ismaillgunes/IR_Programmer/hardware/IR_Programmer.kicad_pcb

## KiCad design hardware/IR_Programmer.kicad_pcb (2026-09-29)

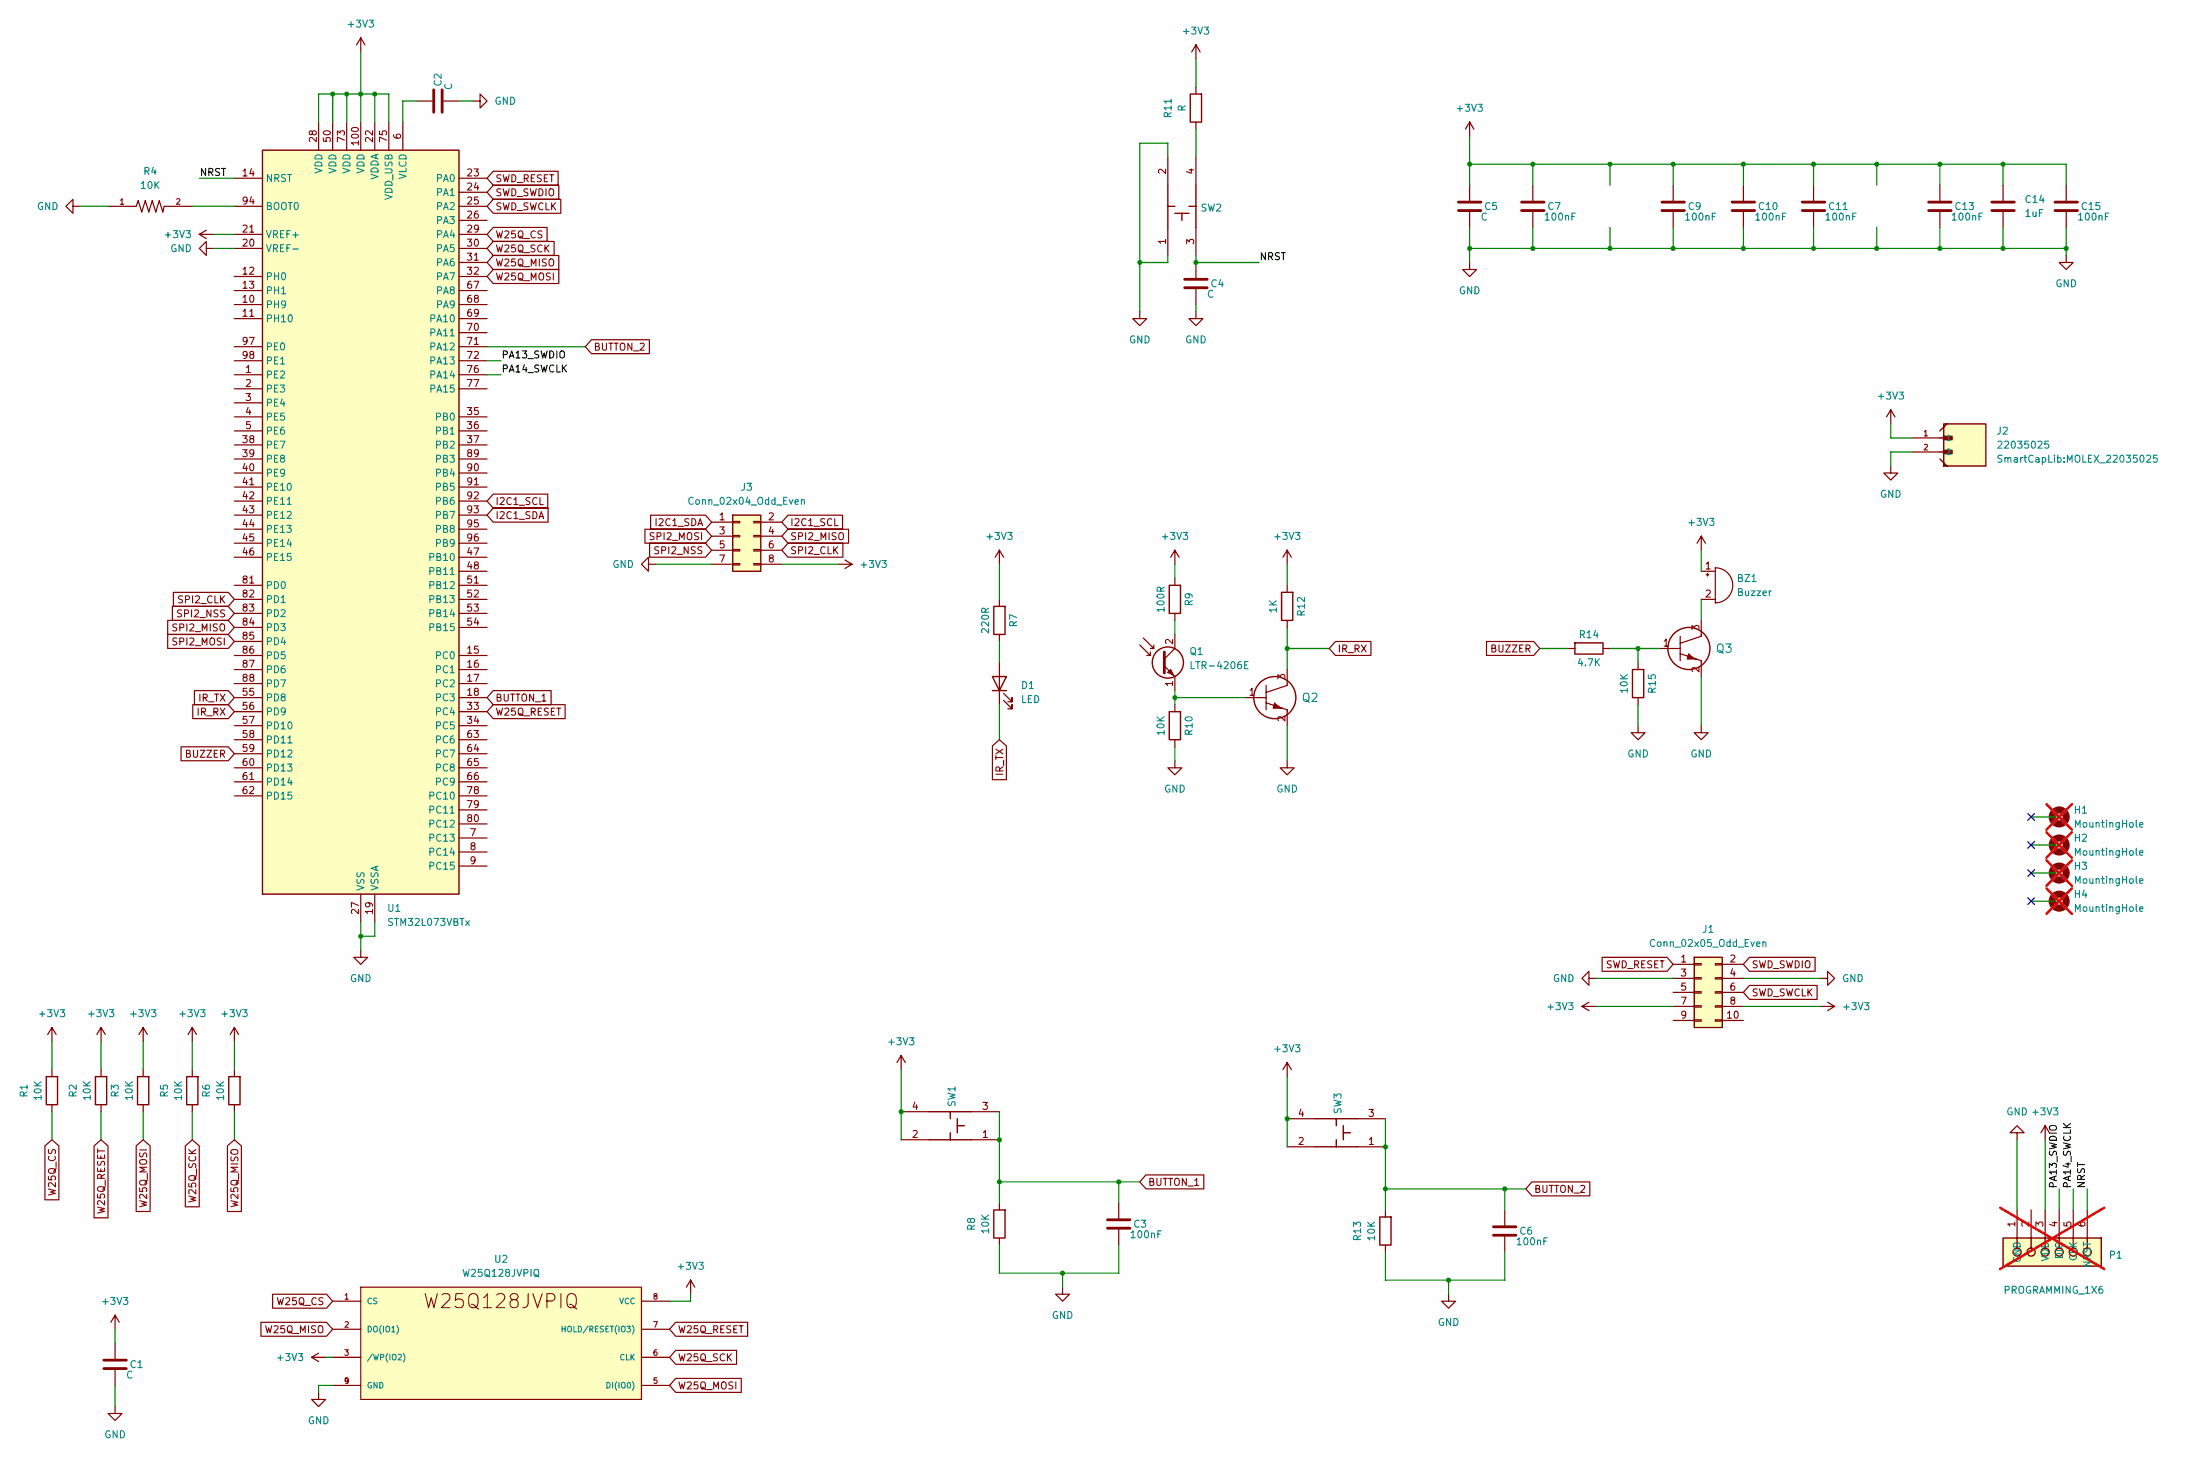
[picture p2: schematic IR_Programmer.kicad_sch]

Parts:
BZ1: Buzzer; Buzzer_12x9.5RM7.6
C1, C2, C4: C; C_0603_1608Metric; Manufacturer Part Num. CC0603KRX7R9BB104
C3, C6, C7, C9, C10, C11, C13, C15: 100nF; C_0603_1608Metric; Manufacturer Part Num. CC0603KRX7R9BB104
C5: C; C_0603_1608Metric; Manufacturer Part Num. CL10A106MQ8NNNC
C14: 1uF; C_0603_1608Metric; Manufacturer Part Number CC0603KRX7R7BB105
D1: LED; D_T-1_P2.54mm_Vertical_AnodeUp
H1, H2, H3, H4: MountingHole; MountingHole_3.5mm_Pad; not fitted
J1: Conn_02x05_Odd_Even; PinHeader_2x05_P2.54mm_Vertical
J2: 22035025; MOLEX_22035025; PARTREV A
J3: Conn_02x04_Odd_Even; PinHeader_2x04_P2.54mm_Vertical
P1: PROGRAMMING_1X6; Programming Connection; not fitted
Q1: LTR-4206E; D_T-1_P2.54mm_Vertical_AnodeUp
Q2, Q3: MMBT3904-TP; SOT-23-3
R1, R2, R3, R5, R6, R8, R10, R13, R15: 10K; R_0603_1608Metric; Manufacturer Part Num. RC0603FR-0710KL
R4: 10K; RESC1607X60N
R7: 220R; R_0603_1608Metric; Manufacturer Part Num. RC0603FR-07220RL
R9: 100R; R_0603_1608Metric; Manufacturer Part Num. RC0603FR-07100RL
R11: R; R_0603_1608Metric; Manufacturer Part Num. RC0603FR-0710KL
R12: 1K; R_0603_1608Metric; Manufacturer Part Num. RC0603FR-071KL
R14: 4.7K; R_0603_1608Metric; Manufacturer Part Num. RC0603FR-074K7L
SW1, SW3: DS1042-03-1-8-KKR-160-10; MANUFACTURER PART NUMBER DS1042-03-1-8-KKR-160-10
SW2: DS1042-07-1-1KRR16008; SW_TS24-62-14-BL-200-SMT-TR-67; CURRENT RATING 50mA; MANUFACTURER PART NUMBER DS1042-07-1-1KRR16008
U1: STM32L073VBTx; LQFP-100_14x14mm_P0.5mm
U2: W25Q128JVPIQ; Manufacturer Part Num. W25Q128JVPIQ

Connections:
+3V3: BZ1.1 (+), C1.1, C5.1, C7.1, C9.1, C10.1, C11.1, C13.1, C14.1, C15.1, J1.7, J1.8, J2.1, J3.8, P1.3 (VDD), R1.2, R2.2, R3.2, R5.2, R6.2, R7.2, R9.2, R11.2, R12.2, SW1.2, SW1.4, SW3.2, SW3.4, U1.21 (VREF+), U1.22 (VDDA), U1.28 (VDD), U1.50 (VDD), U1.73 (VDD), U1.75 (VDD_USB), U1.100 (VDD), U2.3 (/WP(IO2)), U2.8 (VCC)
/NRST: C4.1, P1.6 (NRST), SW2.3, U1.14 (NRST)
/PA13_SWDIO: P1.4 (DIO), U1.72 (PA13)
/PA14_SWCLK: P1.5 (CLK), U1.76 (PA14)
BUTTON_1: C3.1, R8.2, SW1.1, SW1.3, U1.18 (PC3)
BUTTON_2: C6.1, R13.2, SW3.1, SW3.3, U1.71 (PA12)
BUZZER: R14.2, U1.59 (PD12)
GND: C1.2, C2.2, C3.2, C4.2, C5.2, C6.2, C7.2, C9.2, C10.2, C11.2, C13.2, C14.2, C15.2, J1.3, J1.4, J2.2, J3.7, P1.1 (GND), Q2.2, Q3.2, R4.1, R8.1, R10.1, R13.1, R15.1, SW2.1, SW2.2, U1.19 (VSSA), U1.20 (VREF-), U1.27 (VSS), U1.49 (VSS), U1.74 (VSS), U1.99 (VSS), U2.4 (GND), U2.9 (GND)
I2C1_SCL: J3.2, U1.92 (PB6)
I2C1_SDA: J3.1, U1.93 (PB7)
IR_RX: Q2.3, R12.1, U1.56 (PD9)
IR_TX: D1.1 (K), U1.55 (PD8)
unnamed: BZ1.2 (-), Q3.3
unnamed: D1.2 (A), R7.1
unnamed: Q1.2 (C), R9.1
unnamed: Q1.1 (E), Q2.1, R10.2
unnamed: Q3.1, R14.1, R15.2
unnamed: R11.1, SW2.4
unnamed: R4.2, U1.94 (BOOT0)
unnamed: C2.1, U1.6 (VLCD)
SPI2_CLK: J3.6, U1.82 (PD1)
SPI2_MISO: J3.4, U1.84 (PD3)
SPI2_MOSI: J3.3, U1.85 (PD4)
SPI2_NSS: J3.5, U1.83 (PD2)
SWD_RESET: J1.1, U1.23 (PA0)
SWD_SWCLK: J1.6, U1.25 (PA2)
SWD_SWDIO: J1.2, U1.24 (PA1)
W25Q_CS: R1.1, U1.29 (PA4), U2.1 (CS)
W25Q_MISO: R6.1, U1.31 (PA6), U2.2 (DO(IO1))
W25Q_MOSI: R3.1, U1.32 (PA7), U2.5 (DI(IO0))
W25Q_RESET: R2.1, U1.33 (PC4), U2.7 (HOLD/RESET(IO3))
W25Q_SCK: R5.1, U1.30 (PA5), U2.6 (CLK)

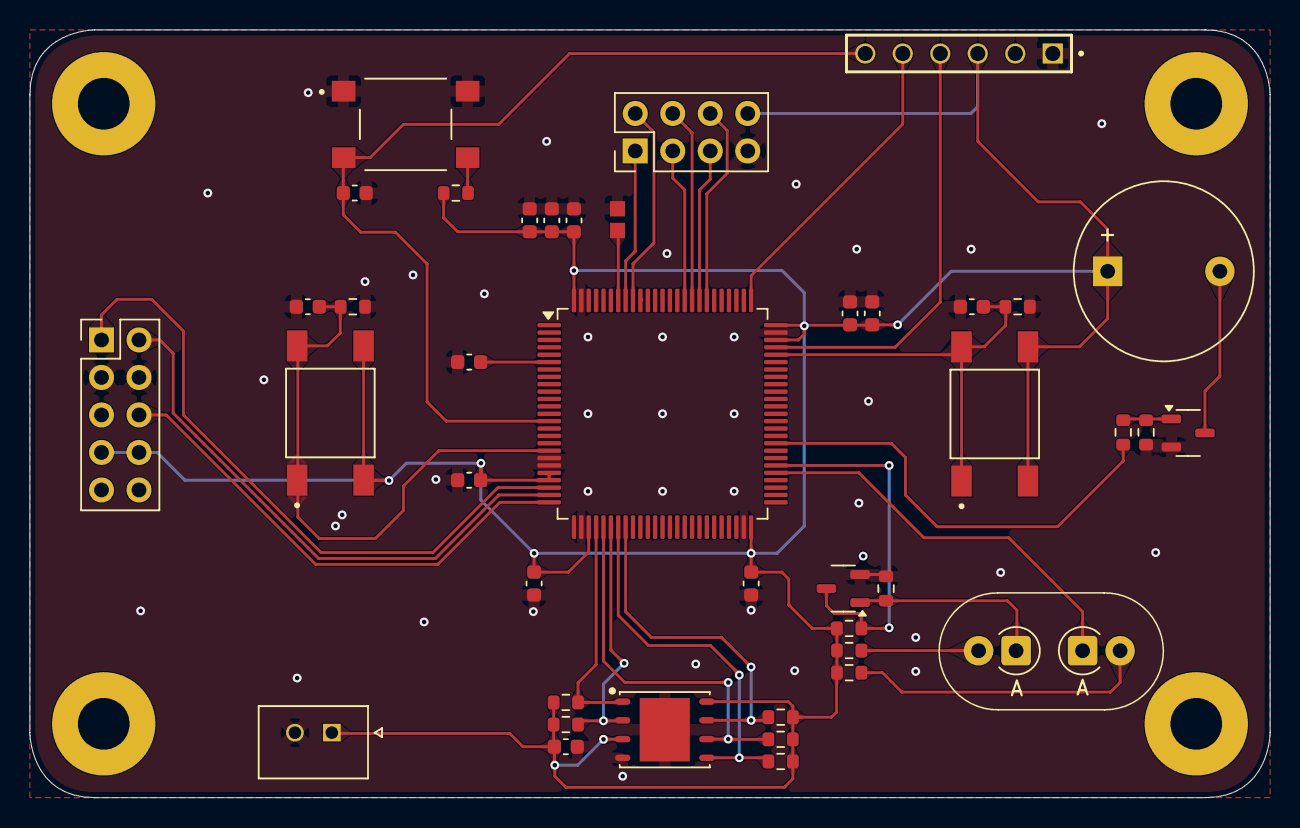
[picture p3: board IR_Programmer.kicad_pcb from above]

Board: 2 copper layers, 84.0 x 52.0 mm, 46 parts (0 on the bottom side), 32 nets.
