ismaillgunes/IR_Programmer/firmware/Core/Inc/main.h

#define BtnSWD_Pin GPIO_PIN_3
#define BtnSWD_GPIO_Port GPIOC
#define SWD_NRST_Pin GPIO_PIN_0
#define SWD_NRST_GPIO_Port GPIOA
#define SWD_SWDIO_Pin GPIO_PIN_1
#define SWD_SWDIO_GPIO_Port GPIOA
#define SWD_SWCLK_Pin GPIO_PIN_2
#define SWD_SWCLK_GPIO_Port GPIOA
#define W25Q_CS_Pin GPIO_PIN_4
#define W25Q_CS_GPIO_Port GPIOA
#define W25Q_RESET_Pin GPIO_PIN_4
#define W25Q_RESET_GPIO_Port GPIOC
#define Buzzer_Pin_Pin GPIO_PIN_12
#define Buzzer_Pin_GPIO_Port GPIOD
#define BtnIR_Pin GPIO_PIN_12
#define BtnIR_GPIO_Port GPIOA
